Jaycar-Electronics/WiFi-Datalogger/images/checkservice.png

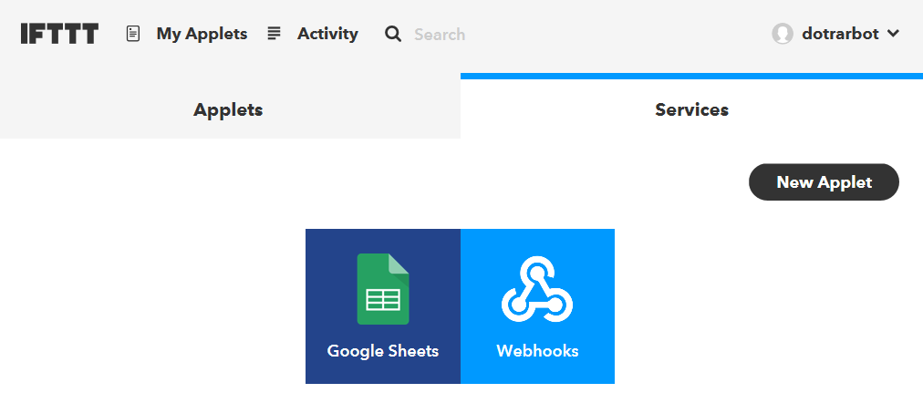
images/checkservice.png
