Jaycar-Electronics/WiFi-Datalogger/images/esp.jpg

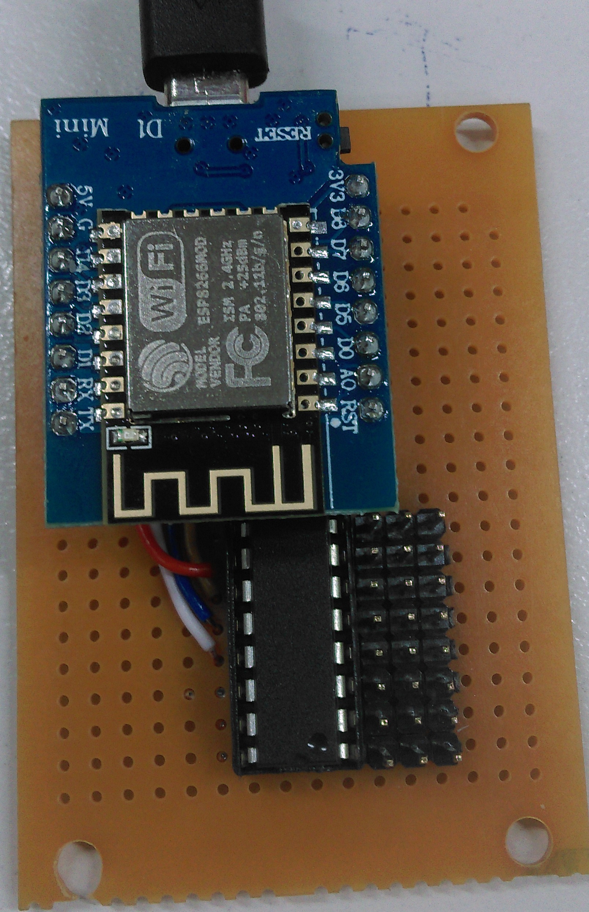
images/esp.jpg
